AdyanshSahai/AquaLux/static/AquaLux.kicad_pcb

## KiCad design KiCAD_project/zdc_fifo_test/zdc_fifo_test.kicad_pcb

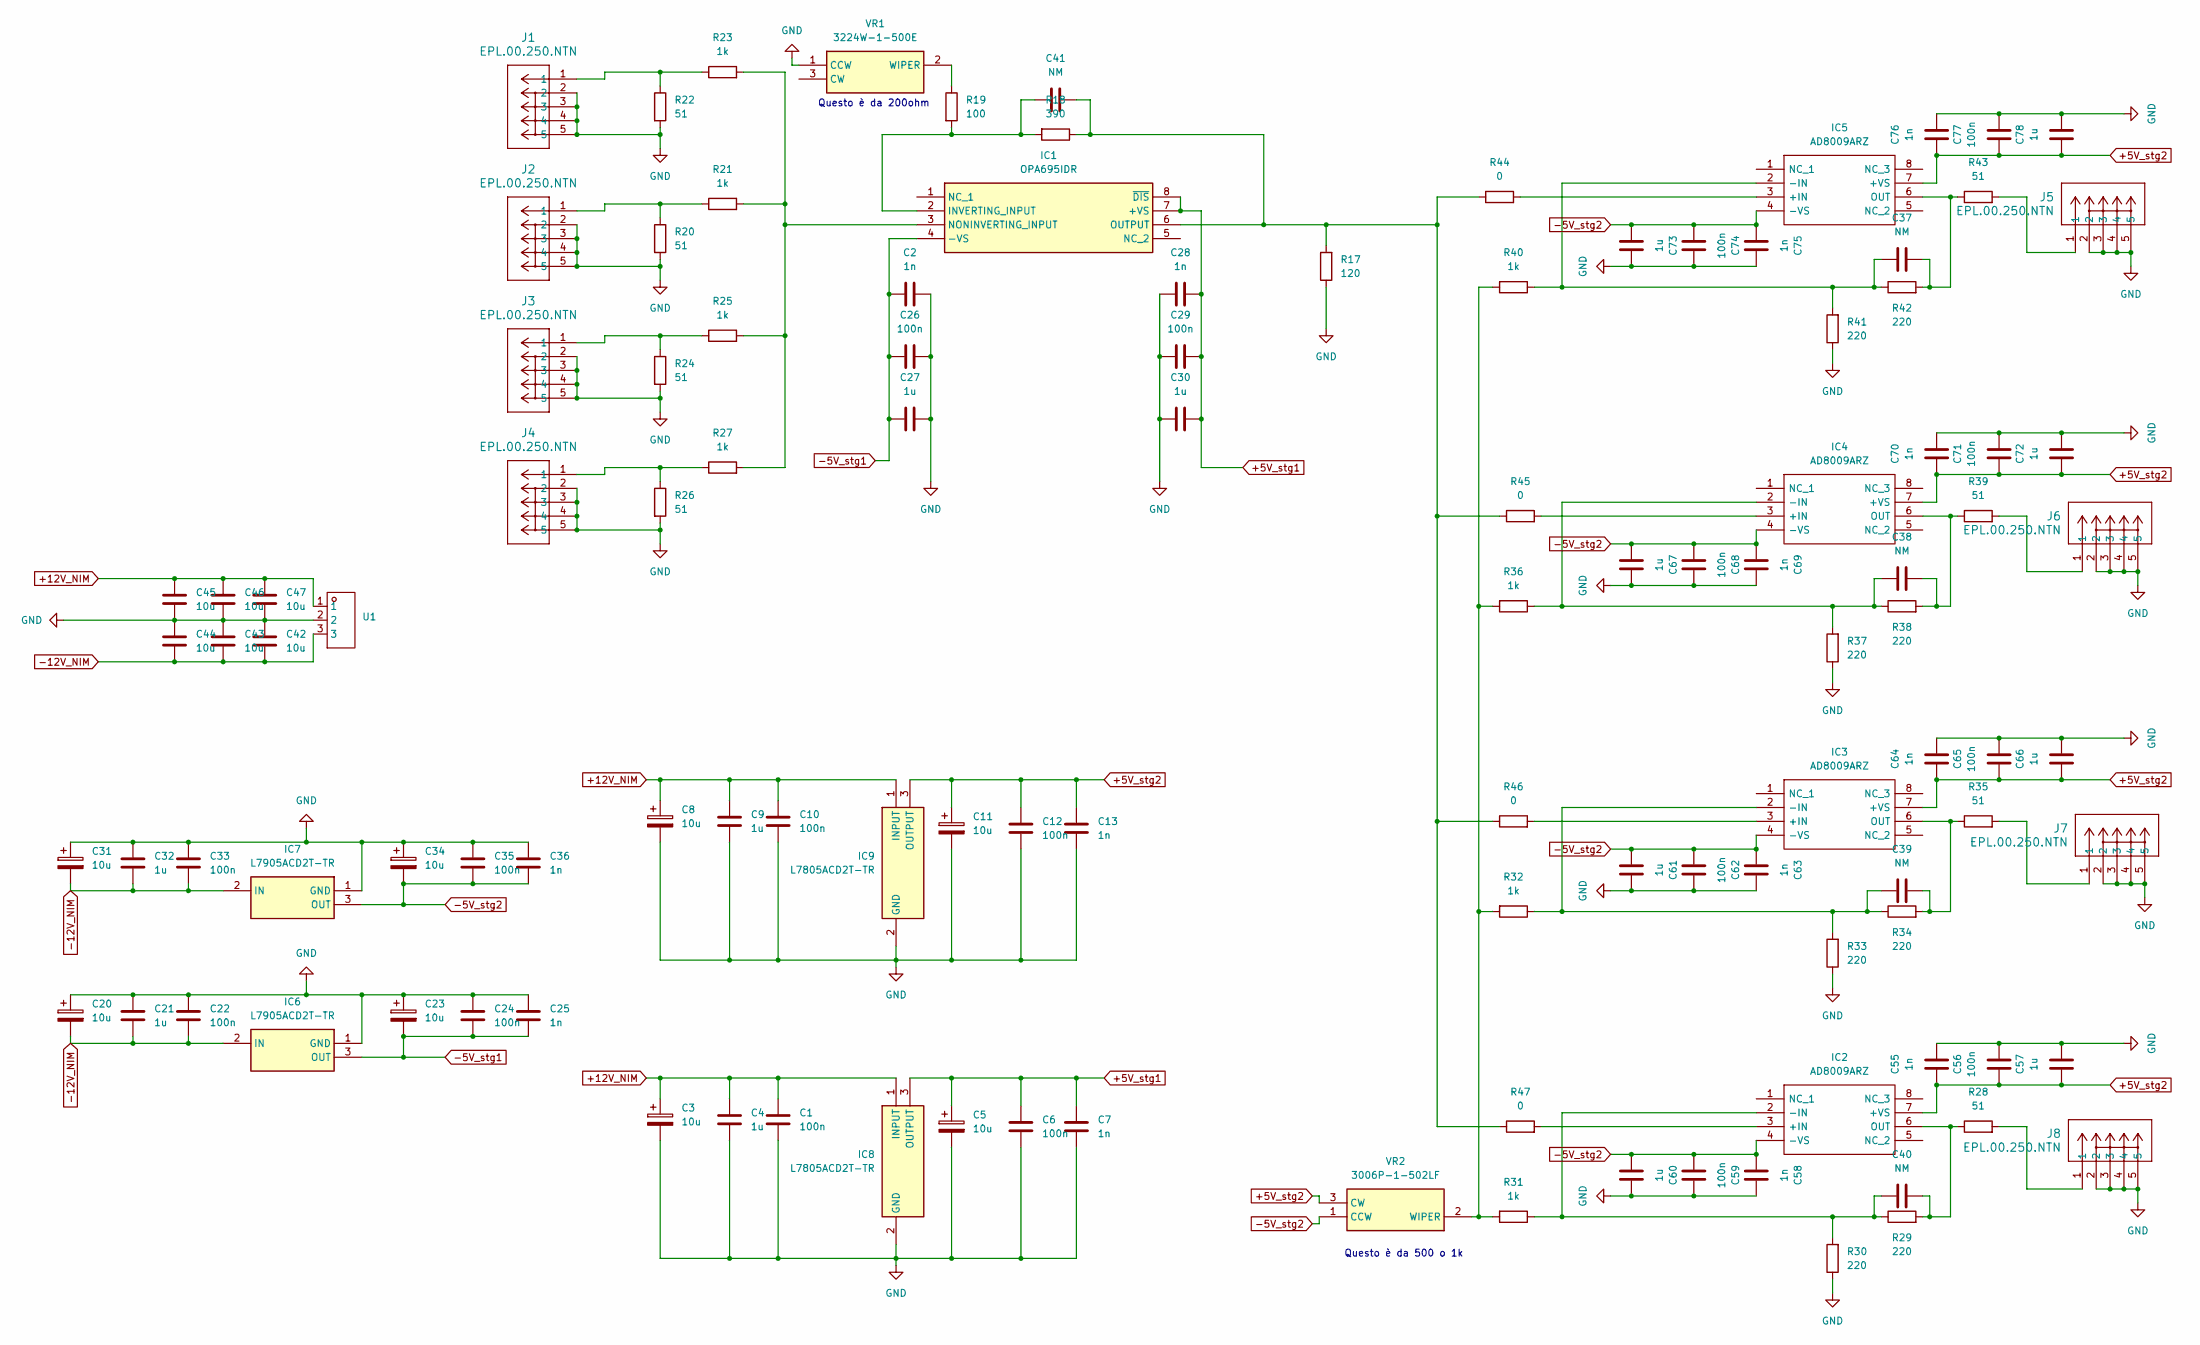
[picture p1: schematic zdc_fifo_test.kicad_sch, $ input 4 output]

Parts:
C1, C6, C10, C12, C22, C24, C26, C29, C33, C35, C56, C59, C62, C65, C68, C71, C74, C77: 100n; C_0402_1005Metric
C2, C7, C13, C25, C28, C36, C55, C58, C63, C64, C69, C70, C75, C76: 1n; C_0402_1005Metric
C3, C5, C8, C11, C31, C34, C42, C43, C44, C45, C46, C47: 10u; C_0805_2012Metric
C4, C9, C21, C30, C32, C57, C60, C61, C66, C67, C72, C73, C78: 1u; C_0603_1608Metric
C20: 10u; C_0805_2012Metric; JLCPCB C2836437
C23: 10u; C_0805_2012Metric; JLCPCB C15850
C27: 1u; C_0603_1608Metric; JLCPCB C15849
C37, C38, C39, C40, C41: NM; C_0402_1005Metric_Pad0.74x0.62mm_HandSolder
IC1: OPA695IDR; SOIC127P600X175-8N; Mouser Part Number 595-OPA695IDR
IC2, IC3, IC4, IC5: AD8009ARZ; SOIC127P600X175-8N; Mouser Part Number 584-AD8009ARZ
IC6, IC7: L7905ACD2T-TR; STB20N95K5; Mouser Part Number 511-L7905ACD2T-TR
IC8, IC9: L7805ACD2T-TR; L7805ACD2TTR; Mouser Part Number 511-L7805ACD2T-TR
J1, J2, J3, J4, J5, J6, J7, J8: EPL.00.250.NTN; CONN_EPK.00.250.NTN_LMO
R17: 120; R_0402_1005Metric
R18: 390; R_0603_1608Metric
R19: 100; R_0402_1005Metric
R20, R22, R24, R26, R28, R35, R39, R43: 51; R_0603_1608Metric
R21, R23, R25, R27, R31, R32, R36, R40: 1k; R_0402_1005Metric
R29, R30, R33, R34, R37, R38, R41, R42: 220; R_0402_1005Metric
R44, R45, R46, R47: 0; R_0603_1608Metric_Pad0.98x0.95mm_HandSolder
U1: CONN-TH_XY126V-5.0-3P; Manufacturer Part XY126V-5.0-3P; LCSC Part Name 1x3P 5mm 直插 排数:1 每排P数:3
VR1: 3224W-1-500E; 3224W1500E; Mouser Part Number 652-3224W-1-500E
VR2: 3006P-1-502LF; 3006P_1; Mouser Part Number 652-3006P-1-502-LF

Connections:
+5V_stg1: C5.1, C6.1, C7.1, C28.1, C29.1, C30.1, IC1.7 (+VS), IC1.8 (~DIS), IC8.3 (OUTPUT)
+5V_stg2: C11.1, C12.1, C13.1, C55.1, C56.1, C57.1, C64.1, C65.1, C66.1, C70.1, C71.1, C72.1, C76.1, C77.1, C78.1, IC2.7 (+VS), IC3.7 (+VS), IC4.7 (+VS), IC5.7 (+VS), IC9.3 (OUTPUT), VR2.3 (CW)
+12V_NIM: C1.1, C3.1, C4.1, C8.1, C9.1, C10.1, C45.1, C46.1, C47.1, IC8.1 (INPUT), IC9.1 (INPUT), U1.1
-5V_stg1: C2.1, C23.2, C24.2, C25.2, C26.1, C27.1, IC1.4 (-VS), IC6.3 (OUT)
-5V_stg2: C34.2, C35.2, C36.2, C58.1, C59.1, C60.1, C61.1, C62.1, C63.1, C67.1, C68.1, C69.1, C73.1, C74.1, C75.1, IC2.4 (-VS), IC3.4 (-VS), IC4.4 (-VS), IC5.4 (-VS), IC7.3 (OUT), VR2.1 (CCW)
-12V_NIM: C20.2, C21.2, C22.2, C31.2, C32.2, C33.2, C42.2, C43.2, C44.2, IC6.2 (IN), IC7.2 (IN), U1.3
GND: C1.2, C2.2, C3.2, C4.2, C5.2, C6.2, C7.2, C8.2, C9.2, C10.2, C11.2, C12.2, C13.2, C20.1, C21.1, C22.1, C23.1, C24.1, C25.1, C26.2, C27.2, C28.2, C29.2, C30.2, C31.1, C32.1, C33.1, C34.1, C35.1, C36.1, C42.1, C43.1, C44.1, C45.2, C46.2, C47.2, C55.2, C56.2, C57.2, C58.2, C59.2, C60.2, C61.2, C62.2, C63.2, C64.2, C65.2, C66.2, C67.2, C68.2, C69.2, C70.2, C71.2, C72.2, C73.2, C74.2, C75.2, C76.2, C77.2, C78.2, IC6.1 (GND), IC7.1 (GND), IC8.2 (GND), IC9.2 (GND), J1.2, J1.3, J1.4, J1.5, J2.2, J2.3, J2.4, J2.5, J3.2, J3.3, J3.4, J3.5, J4.2, J4.3, J4.4, J4.5, J5.2, J5.3, J5.4, J5.5, J6.2, J6.3, J6.4, J6.5, J7.2, J7.3, J7.4, J7.5, J8.2, J8.3, J8.4, J8.5, R17.1, R20.2, R22.2, R24.2, R26.2, R30.1, R33.1, R37.1, R41.1, U1.2, VR1.1 (CCW)
unnamed: C41.2, IC1.2 (INVERTING_INPUT), R18.2, R19.2
unnamed: IC1.3 (NONINVERTING_INPUT), R21.2, R23.2, R25.2, R27.2
unnamed: C41.1, IC1.6 (OUTPUT), R17.2, R18.1, R44.1, R45.1, R46.1, R47.1
unnamed: IC2.3 (+IN), R47.2
unnamed: C40.2, IC2.2 (-IN), R29.1, R30.2, R31.1
unnamed: C40.1, IC2.6 (OUT), R28.1, R29.2
unnamed: IC3.3 (+IN), R46.2
unnamed: C39.2, IC3.2 (-IN), R32.1, R33.2, R34.1
unnamed: C39.1, IC3.6 (OUT), R34.2, R35.1
unnamed: IC4.3 (+IN), R45.2
unnamed: C38.2, IC4.2 (-IN), R36.1, R37.2, R38.1
unnamed: C38.1, IC4.6 (OUT), R38.2, R39.1
unnamed: IC5.3 (+IN), R44.2
unnamed: C37.2, IC5.2 (-IN), R40.1, R41.2, R42.1
unnamed: C37.1, IC5.6 (OUT), R42.2, R43.1
unnamed: J1.1, R22.1, R23.1
unnamed: J2.1, R20.1, R21.1
unnamed: J3.1, R24.1, R25.1
unnamed: J4.1, R26.1, R27.1
unnamed: J5.1, R43.2
unnamed: J6.1, R39.2
unnamed: J7.1, R35.2
unnamed: J8.1, R28.2
unnamed: R19.1, VR1.2 (WIPER)
unnamed: R31.2, R32.2, R36.2, R40.2, VR2.2 (WIPER)

Notes on the sheet:
Questo è da 200ohm
Questo è da 500 o 1k

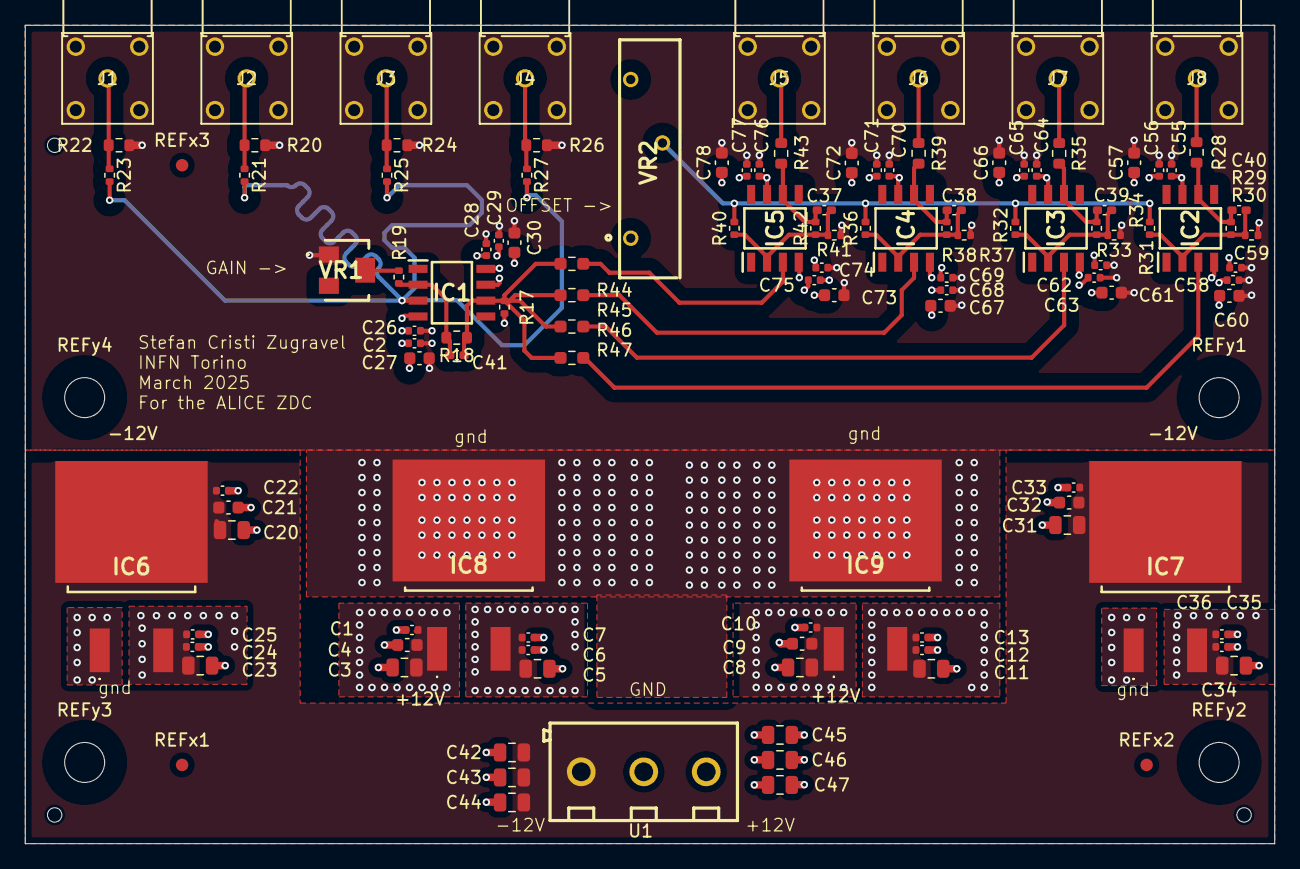
[picture p2: board zdc_fifo_test.kicad_pcb from above]

Board: 6 copper layers, 100.0 x 65.5 mm, 123 parts (0 on the bottom side), 32 nets.

Other parts of the board:
REFx1, REFx2, REFx3: Fiducial_1mm_Mask2mm
REFy1, REFy2, REFy3, REFy4: MountingHole_3.2mm_M3
