AdyanshSahai/AquaLux/src/main.cpp

/*
 * ============================================================
 *  AquaLux — Hydration Alarm System
 *  Platform : ESP32-S2 Mini (LOLIN / Wemos S2 Mini)
 *  Framework: Arduino (PlatformIO)
 * ============================================================
 *
 *  Boot flow
 *  ─────────
 *  1. Init pins + Serial
 *  2. Load Preferences (WiFi creds + alarm time)
 *  3. If creds found  → connect home WiFi → NTP sync → disconnect → AP mode
 *     If no creds     → AP mode immediately (first-time setup)
 *  4. Serve web UI at 192.168.4.1: set alarm, update WiFi, view sensor states
 *  5. At alarm time   → pulse buzzer via 2N2222 (500 ms on / 500 ms off)
 *  6. Alarm dismiss   → light ON + capacitive sensor triggered, both held >= 2 s
 *  7. 3 am daily      → brief home-WiFi reconnect for NTP resync
 *  8. Reset button    → hold 3 s → wipe Preferences → beep → reboot
 *
 *  File layout
 *  ───────────
 *  config.h        — all pin and timing constants (#defines)
 *  globals.h/.cpp  — shared state variables (extern declarations + definitions)
 *  wifi_ntp.h/.cpp — parseAlarmTime, loadPreferences, syncNTP
 *  sensors.h/.cpp  — readSensors
 *  alarm.h/.cpp    — triggerAlarm, updateBuzzerPulse, handleAlarmDismiss
 *  webserver.h/.cpp— embedded HTML + HTTP route handlers
 *  reset_button.h/.cpp — handleResetButton
 *  main.cpp        — setup() and loop() (this file)
 *
 *  NOTE — light sleep: cannot be used while the AsyncWebServer AP is active.
 *  Light sleep suspends the WiFi radio, which disconnects AP clients.
 *  Using delay() instead — it yields to FreeRTOS background tasks (WiFi stack,
 *  web server handler task, watchdog) without touching the radio.
 */

// ── Pull in all subsystems ────────────────────────────────────
// Each header transitively includes globals.h → all library headers + config.h,
// so this list is all that is needed here.
#include "wifi_ntp.h"
#include "sensors.h"
#include "alarm.h"
#include "webserver.h"
#include "reset_button.h"

// ============================================================
//  setup()
// ============================================================

void setup() {
    // ── Serial monitor ────────────────────────────────────────
    Serial.begin(115200);
    Serial.setTxTimeoutMs(0); // ESP32-S2 uses USB CDC — without this, Serial.print blocks/drops
                               // output if the USB host isn't ready yet; 0 = never block, just drop
    delay(2000);              // Give USB CDC time to enumerate before printing anything
    Serial.println("\n===== AquaLux BOOT =====");

    // ── Pin configuration ─────────────────────────────────────
    pinMode(BUZZER_PIN,      OUTPUT);
    digitalWrite(BUZZER_PIN, LOW);          // Explicitly off on boot

    pinMode(CAP_SENSOR_PIN,  INPUT);       // Capacitive sensor module has its own pull resistors
    pinMode(PHOTO_PIN,       INPUT);       // LDR module DO pin; module has its own pull resistors
    pinMode(RESET_PIN,       INPUT_PULLUP); // Internal pull-up; LOW = button pressed = counting down

    Serial.println("[SETUP] Pins configured");

    // ── Load stored configuration from NVS ────────────────────
    bool hasCreds = loadPreferences(); // Populates storedSSID, storedPassword, alarmHour, alarmMinute

    // ── NTP sync or first-time AP setup ───────────────────────
    // IMPORTANT: timeClient.begin() opens a lwIP UDP socket and must be called AFTER the WiFi
    // stack is initialised (i.e. after WiFi.mode()). Calling it before WiFi.mode() causes an
    // "Invalid mbox" assertion crash inside tcpip_send_msg_wait_sem.
    if (hasCreds) {
        // Credentials available — sync time before opening the AP so the clock is correct immediately
        Serial.println("[SETUP] Credentials found — running NTP sync");
        syncNTP(); // Calls WiFi.mode(AP_STA), connects, timeClient.begin()+forceUpdate, disconnects, softAP
    } else {
        // No credentials — bring up AP first, then open the UDP socket for NTP
        Serial.println("[SETUP] No credentials — entering AP setup mode");
        WiFi.mode(WIFI_AP);
        WiFi.setTxPower(WIFI_POWER_8_5dBm); // Reduce TX power to cut peak current draw
        WiFi.softAP(AP_SSID);           // Open AP, no password
        timeClient.begin();              // Safe here — WiFi stack is now initialised
        Serial.printf("[SETUP] AP up: SSID='%s'  IP=%s\n", AP_SSID, AP_GATEWAY_IP);
    }

    // ── Start web server ──────────────────────────────────────
    // AP must be running before this; server.begin() registers with the WiFi event loop
    setupWebServer();

    // ── Initial sensor snapshot ───────────────────────────────
    // Populate the global sensor booleans so the /status endpoint has real values immediately
    readSensors();

    Serial.printf("[SETUP] Boot complete | Alarm=%02d:%02d | Time known=%s\n",
                  alarmHour, alarmMinute,
                  isAnyTimeSet() ? "YES" : "NO (set manually in Config or sync WiFi)");
    Serial.println("===== AquaLux RUNNING =====\n");
}

// ============================================================
//  loop()
// ============================================================

void loop() {
    // ── 1. Reset button ───────────────────────────────────────
    // Checked every iteration — highest priority so a reset can interrupt even an active alarm
    handleResetButton();

    // ── 2. Time-dependent logic (only valid once NTP has synced) ──
    if (isAnyTimeSet()) {
        int curHour   = getCurrentHour();
        int curMinute = getCurrentMinute();

        // ── 2a. Daily 3 am NTP resync ─────────────────────────
        // Fires once per day at exactly NTP_RESYNC_HOUR:NTP_RESYNC_MINUTE
        if (curHour == NTP_RESYNC_HOUR && curMinute == NTP_RESYNC_MINUTE && !ntpResynced3am) {
            Serial.println("[LOOP] 3 am NTP resync triggered");
            syncNTP();             // Reconnect home WiFi, resync, disconnect, restore AP
            ntpResynced3am = true; // Block re-trigger for the rest of this minute
        } else if (!(curHour == NTP_RESYNC_HOUR && curMinute == NTP_RESYNC_MINUTE)) {
            // Reset flag once we leave the 3 am minute so it fires again tomorrow
            ntpResynced3am = false;
        }

        // ── 2b. Alarm trigger ─────────────────────────────────
        if (curHour == alarmHour && curMinute == alarmMinute) {
            if (!alarmActive && !alarmFiredThisMinute) {
                // Fire once per clock-minute; alarmFiredThisMinute prevents re-trigger if the
                // alarm is dismissed and the minute hasn't changed yet (e.g. dismissed at 07:00:30)
                Serial.printf("[LOOP] Alarm time %02d:%02d reached — triggering\n", curHour, curMinute);
                triggerAlarm();
                alarmFiredThisMinute = true;
            }
        } else {
            // Outside the alarm minute — clear the one-shot guard so it fires again tomorrow
            alarmFiredThisMinute = false;
        }
    }

    // ── 3. Sensor read (every iteration) + active alarm handling ──
    readSensors(); // Always refresh sensor globals so the web UI stays live even without an active alarm

    if (alarmActive) {
        updateBuzzerPulse();  // Toggle buzzer ON/OFF per BUZZER_ON_MS / BUZZER_OFF_MS (non-blocking)
        handleAlarmDismiss(); // Run 2 s debounce; silences alarm if all conditions held long enough
    }

    // ── 4. Yield delay ────────────────────────────────────────
    // Light sleep is NOT used: it suspends the WiFi radio, which disconnects AP clients and
    // pauses the AsyncWebServer. delay() yields the CPU to all FreeRTOS background tasks
    // (WiFi stack, web server handler task, watchdog timer) without disturbing the radio.
    delay(alarmActive ? LOOP_ALARM_DELAY_MS : LOOP_IDLE_DELAY_MS);
}
