AdyanshSahai/AquaLux/src/webserver.cpp

// ============================================================
//  webserver.cpp — Embedded HTML UI and HTTP route handlers
//
//  Routes:
//    GET  /         — serve the three-mode UI from PROGMEM
//    GET  /status   — JSON snapshot of time + sensor/buzzer/alarm states
//    POST /setalarm — update alarm time in NVS + globals (no reboot)
//    POST /buzzer   — manually drive BUZZER_PIN (dev mode)
//    POST /save     — write WiFi credentials + current alarm to NVS → reboot
// ============================================================

#include "webserver.h"
#include "wifi_ntp.h"   // parseAlarmTime()

static bool     buzzerTestState = false;
static int      scanState       = 0;   // 0=idle, 1=scanning, 2=done
static String   scanJson        = "[]";
static uint32_t calNothing      = 0;   // raw cap reading with nothing on pad
static uint32_t calBottle       = 0;   // raw cap reading with bottle on pad
static uint32_t calHand         = 0;   // raw cap reading with hand on pad

static const char INDEX_HTML[] PROGMEM = R"rawliteral(
<!DOCTYPE html>
<html lang="en">
<head>
  <meta charset="UTF-8">
  <meta name="viewport" content="width=device-width,initial-scale=1">
  <title>AquaLux</title>
  <style>
    *, *::before, *::after { box-sizing: border-box; margin: 0; padding: 0; }

    body {
      background: #0d0d0d;
      color: #e0e0e0;
      font-family: -apple-system, BlinkMacSystemFont, 'Segoe UI', sans-serif;
      min-height: 100vh;
    }

    /* ── Top bar ─────────────────────────────────────────────── */
    .topbar {
      position: relative;
      display: flex;
      align-items: center;
      height: 52px;
      padding: 0 16px;
      background: #141414;
      border-bottom: 1px solid #1f1f1f;
      z-index: 100;
    }

    .topbar-title {
      position: absolute;
      left: 50%;
      transform: translateX(-50%);
      font-size: 1rem;
      font-weight: 700;
      color: #fff;
      letter-spacing: 0.08em;
    }

    /* ── Hamburger button ────────────────────────────────────── */
    .ham-btn {
      background: none;
      border: none;
      cursor: pointer;
      padding: 6px;
      display: flex;
      flex-direction: column;
      gap: 5px;
    }

    .ham-btn span {
      display: block;
      width: 22px;
      height: 2px;
      background: #ccc;
      border-radius: 2px;
      transition: background 0.2s;
    }

    .ham-btn:hover span { background: #fff; }

    /* ── Dropdown menu ───────────────────────────────────────── */
    .dropdown {
      position: absolute;
      top: 52px;
      left: 0;
      width: 180px;
      background: #1a1a1a;
      border: 1px solid #2a2a2a;
      border-radius: 0 0 10px 10px;
      z-index: 200;
      overflow: hidden;
    }

    .dropdown.hidden { display: none; }

    .dropdown a {
      display: block;
      padding: 13px 18px;
      font-size: 0.9rem;
      color: #ccc;
      cursor: pointer;
      border-bottom: 1px solid #222;
      transition: background 0.15s, color 0.15s;
      user-select: none;
    }

    .dropdown a:last-child { border-bottom: none; }
    .dropdown a:hover { background: #222; color: #fff; }
    .dropdown a.active { color: #4ade80; }

    /* ── Main content ────────────────────────────────────────── */
    .content {
      padding: 28px 16px 48px;
      max-width: 420px;
      margin: 0 auto;
    }

    .mode-panel { display: none; }
    .mode-panel.active { display: block; }

    /* ── Section headings ────────────────────────────────────── */
    .panel-title {
      font-size: 1.1rem;
      font-weight: 700;
      color: #fff;
      margin-bottom: 6px;
    }

    .panel-sub {
      font-size: 0.75rem;
      color: #555;
      margin-bottom: 24px;
    }

    /* ── Cards ───────────────────────────────────────────────── */
    .card {
      background: #141414;
      border: 1px solid #1f1f1f;
      border-radius: 14px;
      overflow: hidden;
      margin-bottom: 14px;
    }

    .row {
      display: flex;
      align-items: center;
      justify-content: space-between;
      padding: 14px 16px;
      border-bottom: 1px solid #1a1a1a;
    }

    .row:last-child { border-bottom: none; }

    .label { font-size: 0.9rem; color: #ccc; }

    /* ── Form inputs ─────────────────────────────────────────── */
    .field { margin-bottom: 16px; }

    .field label {
      display: block;
      font-size: 0.78rem;
      color: #888;
      margin-bottom: 6px;
      letter-spacing: 0.04em;
      text-transform: uppercase;
    }

    .field input {
      width: 100%;
      background: #141414;
      border: 1px solid #2a2a2a;
      border-radius: 10px;
      color: #fff;
      font-size: 1rem;
      padding: 11px 14px;
      outline: none;
      transition: border-color 0.2s;
      -webkit-appearance: none;
    }

    .field input:focus { border-color: #4ade80; }
    .field input:disabled {
      opacity: 0.4;
      cursor: not-allowed;
    }

    /* ── Buttons ─────────────────────────────────────────────── */
    .btn {
      width: 100%;
      padding: 13px;
      border: none;
      border-radius: 10px;
      font-size: 0.95rem;
      font-weight: 600;
      cursor: pointer;
      transition: opacity 0.2s;
    }

    .btn:disabled { opacity: 0.4; cursor: not-allowed; }
    .btn-green { background: #166534; color: #4ade80; }
    .btn-green:hover:not(:disabled) { opacity: 0.85; }
    .btn-blue  { background: #1e3a5f; color: #60a5fa; }
    .btn-blue:hover:not(:disabled)  { opacity: 0.85; }

    /* ── Status light (alarm mode) ───────────────────────────── */
    .status-wrap {
      display: flex;
      flex-direction: column;
      align-items: center;
      margin-top: 28px;
      gap: 10px;
    }

    .status-dot {
      width: 40px;
      height: 40px;
      border-radius: 50%;
      background: #166534;
      box-shadow: 0 0 12px #4ade8044;
      transition: background 0.3s, box-shadow 0.3s;
    }

    .status-dot.alarming {
      background: #991b1b;
      box-shadow: 0 0 18px #ef444466;
      animation: pulse-red 1s ease-in-out infinite;
    }

    @keyframes pulse-red {
      0%, 100% { box-shadow: 0 0 12px #ef444444; }
      50%       { box-shadow: 0 0 28px #ef4444aa; }
    }

    .status-label {
      font-size: 0.8rem;
      color: #666;
    }

    /* ── Sensor badges ───────────────────────────────────────── */
    .badge {
      font-size: 0.7rem;
      font-weight: 600;
      letter-spacing: 0.06em;
      text-transform: uppercase;
      padding: 3px 8px;
      border-radius: 20px;
      background: #1f1f1f;
      color: #555;
      min-width: 40px;
      text-align: center;
      transition: background 0.2s, color 0.2s;
    }

    .badge.on  { background: #14532d; color: #4ade80; }
    .badge.off { background: #1f1f1f; color: #555; }

    /* ── Time display (dev mode) ─────────────────────────────── */
    .time-display {
      font-size: 2rem;
      font-weight: 700;
      color: #fff;
      font-variant-numeric: tabular-nums;
      letter-spacing: 0.04em;
      margin-bottom: 20px;
    }

    /* ── Toggle switch ───────────────────────────────────────── */
    .toggle {
      position: relative;
      width: 44px;
      height: 24px;
      flex-shrink: 0;
    }

    .toggle input {
      opacity: 0;
      width: 0;
      height: 0;
      position: absolute;
    }

    .slider {
      position: absolute;
      inset: 0;
      background: #333;
      border-radius: 24px;
      cursor: pointer;
      transition: background 0.2s;
    }

    .slider::before {
      content: '';
      position: absolute;
      width: 18px;
      height: 18px;
      left: 3px;
      top: 3px;
      background: #888;
      border-radius: 50%;
      transition: transform 0.2s, background 0.2s;
    }

    .toggle input:checked + .slider { background: #166534; }
    .toggle input:checked + .slider::before {
      transform: translateX(20px);
      background: #4ade80;
    }

    /* ── Setup message ───────────────────────────────────────── */
    .msg {
      font-size: 0.8rem;
      margin-top: 12px;
      padding: 10px 14px;
      border-radius: 8px;
      display: none;
    }

    .msg.ok  { background: #14532d44; color: #4ade80; display: block; }
    .msg.err { background: #7f1d1d44; color: #f87171; display: block; }

    /* ── WiFi scan results ───────────────────────────────────── */
    .scan-list {
      margin-top: 8px;
      border: 1px solid #2a2a2a;
      border-radius: 10px;
      overflow: hidden;
      display: none;
    }

    .scan-list.visible { display: block; }

    .scan-item {
      display: flex;
      align-items: center;
      justify-content: space-between;
      padding: 11px 14px;
      border-bottom: 1px solid #1a1a1a;
      cursor: pointer;
      transition: background 0.15s;
    }

    .scan-item:last-child { border-bottom: none; }
    .scan-item:hover { background: #1e1e1e; }

    .scan-item .ssid-name { font-size: 0.9rem; color: #ddd; }
    .scan-item .rssi {
      font-size: 0.75rem;
      color: #555;
    }

    /* ── Saved network select ────────────────────────────────── */
    .net-select {
      width: 100%;
      background: #141414;
      border: 1px solid #2a2a2a;
      border-radius: 10px;
      color: #fff;
      font-size: 1rem;
      padding: 11px 14px;
      outline: none;
      -webkit-appearance: none;
      appearance: none;
      cursor: pointer;
    }
    .net-select:focus { border-color: #4ade80; }
    .net-select option { background: #1a1a1a; }

    /* ── Calibration value display ───────────────────────────── */
    .cal-row {
      display: flex;
      justify-content: space-between;
      font-size: 0.78rem;
      color: #666;
    }
    .cal-row span { color: #aaa; font-variant-numeric: tabular-nums; }
  </style>
</head>
<body>

  <!-- ── Top bar ──────────────────────────────────────────── -->
  <header class="topbar">
    <button class="ham-btn" id="ham-btn" aria-label="Menu">
      <span></span><span></span><span></span>
    </button>
    <span class="topbar-title">AquaLux</span>
  </header>

  <!-- ── Dropdown nav ─────────────────────────────────────── -->
  <nav class="dropdown hidden" id="dropdown">
    <a id="nav-alarm"  class="active" onclick="setMode('alarm')">Alarm</a>
    <a id="nav-setup"                 onclick="setMode('setup')">Setup</a>
    <a id="nav-dev"                   onclick="setMode('dev')">Dev</a>
    <a id="nav-config"                onclick="setMode('config')">Config</a>
  </nav>

  <!-- ── Content ──────────────────────────────────────────── -->
  <div class="content">

    <!-- ── ALARM MODE ──────────────────────────────────────── -->
    <section class="mode-panel active" id="panel-alarm">
      <p class="panel-title">Alarm</p>
      <p class="panel-sub">Set your daily hydration reminder</p>

      <div class="card">
        <div class="row" style="flex-direction:column;align-items:flex-start;gap:10px;">
          <div class="field" style="width:100%;margin-bottom:0;">
            <label>Alarm Time</label>
            <input type="time" id="alarm-input" value="07:00">
          </div>
          <button class="btn btn-green" id="save-btn" onclick="saveAlarm()">Save</button>
        </div>
      </div>

      <div class="status-wrap">
        <div class="status-dot" id="status-dot"></div>
        <span class="status-label" id="status-label">Not ringing</span>
      </div>
    </section>

    <!-- ── SETUP MODE ──────────────────────────────────────── -->
    <section class="mode-panel" id="panel-setup">
      <p class="panel-title">WiFi Setup</p>
      <p class="panel-sub">Connect to home WiFi for automatic time sync</p>

      <div class="card">
        <div class="row" style="flex-direction:column;align-items:flex-start;gap:4px;">
          <div class="field" style="width:100%;">
            <label>Saved Networks</label>
            <select class="net-select" id="net-select" onchange="onNetSelect()">
              <option value="">-- New network --</option>
            </select>
          </div>
          <div class="field" style="width:100%;">
            <label>Network Name (SSID)</label>
            <input type="text" id="ssid-input" placeholder="Your WiFi name" autocomplete="off">
          </div>
          <div class="field" style="width:100%;margin-bottom:0;">
            <label>Password</label>
            <input type="text" id="pass-input" placeholder="WiFi password" autocomplete="off">
          </div>
        </div>
        <div class="row">
          <button class="btn btn-blue" id="connect-btn" onclick="saveWifi()">Connect &amp; Sync</button>
        </div>
      </div>

      <p class="msg" id="setup-msg"></p>

      <div class="card" style="margin-top:14px;">
        <div class="row">
          <span class="label">Current time</span>
          <span style="font-size:1rem;font-weight:700;color:#fff;font-variant-numeric:tabular-nums;" id="setup-time">--:--:--</span>
        </div>
        <div class="row">
          <button class="btn btn-blue" id="sync-btn" onclick="syncTime()">Sync Time Now</button>
        </div>
      </div>
    </section>

    <!-- ── DEV MODE ────────────────────────────────────────── -->
    <section class="mode-panel" id="panel-dev">
      <p class="panel-title">Dev</p>
      <p class="panel-sub">Live sensor readings and buzzer control</p>

      <div class="time-display" id="cur-time">--:--:--</div>

      <div class="card">
        <div class="row">
          <span class="label">Capacitive sensor</span>
          <span style="display:flex;align-items:center;gap:8px;">
            <span style="font-size:0.85rem;color:#aaa;font-variant-numeric:tabular-nums;" id="cap-raw">--</span>
            <span class="badge off" id="b-cap">OFF</span>
          </span>
        </div>
        <div class="row">
          <span class="label">Photoresistor</span>
          <span class="badge off" id="b-light">OFF</span>
        </div>
        <div class="row">
          <span class="label">Alarm active</span>
          <span class="badge off" id="b-alarm">OFF</span>
        </div>
      </div>

      <div class="card">
        <div class="row">
          <span class="label">Buzzer</span>
          <label class="toggle">
            <input type="checkbox" id="toggle-buzzer" onchange="setBuzzer(this.checked)">
            <span class="slider"></span>
          </label>
        </div>
      </div>

    </section>

    <!-- ── CONFIG MODE ───────────────────────────────────────── -->
    <section class="mode-panel" id="panel-config">
      <p class="panel-title">Config</p>
      <p class="panel-sub">Device status and threshold settings</p>

      <div class="card">
        <div class="row">
          <span class="label">Stored SSID</span>
          <span style="font-size:0.85rem;color:#aaa;max-width:55%;overflow:hidden;text-overflow:ellipsis;white-space:nowrap;" id="cfg-ssid">--</span>
        </div>
        <div class="row">
          <span class="label">NTP synced</span>
          <span class="badge off" id="cfg-ntp">NO</span>
        </div>
        <div class="row">
          <span class="label">Current time</span>
          <span style="font-size:0.85rem;color:#fff;font-variant-numeric:tabular-nums;" id="cfg-time">--:--:--</span>
        </div>
      </div>

      <div class="card" style="margin-top:14px;">
        <div class="row" style="flex-direction:column;align-items:flex-start;gap:12px;">
          <span class="label" style="font-weight:600;color:#fff;">Set Time Manually</span>
          <input type="time" id="manual-time" step="1" style="width:100%;background:#141414;border:1px solid #2a2a2a;border-radius:10px;color:#fff;font-size:1rem;padding:11px 14px;outline:none;">
          <button class="btn btn-green" id="manual-time-btn" onclick="setManualTime()">Set Time</button>
        </div>
      </div>

      <div class="card" style="margin-top:14px;">
        <div class="row" style="flex-direction:column;align-items:flex-start;gap:12px;">
          <span class="label" style="font-weight:600;color:#fff;">Cap Thresholds</span>
          <div class="field" style="width:100%;margin-bottom:0;">
            <label>Min (bottle lower bound)</label>
            <input type="number" id="thresh-min" placeholder="e.g. 17000">
          </div>
          <div class="field" style="width:100%;margin-bottom:0;">
            <label>Max (bottle upper bound)</label>
            <input type="number" id="thresh-max" placeholder="e.g. 21000">
          </div>
          <button class="btn btn-green" id="thresh-save-btn" onclick="saveThresholds()">Save Thresholds</button>
        </div>
      </div>

      <div class="card" style="margin-top:14px;">
        <div class="row" style="flex-direction:column;align-items:flex-start;gap:12px;">
          <span class="label" style="font-weight:600;color:#fff;">Auto-Calibrate</span>
          <p style="font-size:0.75rem;color:#555;margin-top:-4px;">Place each item on the pad, then tap its button.</p>
          <div style="display:flex;gap:8px;width:100%;">
            <button class="btn btn-blue"  id="cal-nothing-btn" onclick="calibrate('nothing')" style="flex:1;font-size:0.8rem;padding:10px 4px;">Nothing</button>
            <button class="btn btn-green" id="cal-bottle-btn"  onclick="calibrate('bottle')"  style="flex:1;font-size:0.8rem;padding:10px 4px;">Bottle</button>
            <button class="btn btn-blue"  id="cal-hand-btn"    onclick="calibrate('hand')"    style="flex:1;font-size:0.8rem;padding:10px 4px;">Hand</button>
          </div>
          <div id="cal-status" style="width:100%;"></div>
        </div>
      </div>
    </section>

  </div><!-- .content -->

  <script>
    // ── Mode switching ────────────────────────────────────────
    function setMode(mode) {
      document.querySelectorAll('.mode-panel').forEach(p => p.classList.remove('active'));
      document.querySelectorAll('.dropdown a').forEach(a => a.classList.remove('active'));
      document.getElementById('panel-' + mode).classList.add('active');
      document.getElementById('nav-' + mode).classList.add('active');
      document.getElementById('dropdown').classList.add('hidden');
    }

    document.getElementById('ham-btn').addEventListener('click', function(e) {
      e.stopPropagation();
      document.getElementById('dropdown').classList.toggle('hidden');
    });

    document.addEventListener('click', function(e) {
      const dd = document.getElementById('dropdown');
      if (!dd.classList.contains('hidden') &&
          !dd.contains(e.target) &&
          e.target !== document.getElementById('ham-btn')) {
        dd.classList.add('hidden');
      }
    });

    // ── Alarm save ────────────────────────────────────────────
    async function saveAlarm() {
      const val = document.getElementById('alarm-input').value;
      if (!val) return;
      const btn = document.getElementById('save-btn');
      btn.disabled = true;
      try {
        const r = await fetch('/setalarm', {
          method: 'POST',
          body: new URLSearchParams({ alarm: val })
        });
        btn.textContent = r.ok ? 'Saved!' : 'Error';
        setTimeout(() => { btn.textContent = 'Save'; btn.disabled = false; }, 2000);
      } catch(_) {
        btn.textContent = 'Error';
        setTimeout(() => { btn.textContent = 'Save'; btn.disabled = false; }, 2000);
      }
    }

    // ── WiFi save (reboots device) ────────────────────────────
    async function saveWifi() {
      const ssid = document.getElementById('ssid-input').value.trim();
      const pass = document.getElementById('pass-input').value;
      const msg  = document.getElementById('setup-msg');
      const btn  = document.getElementById('connect-btn');

      if (!ssid) {
        msg.className = 'msg err';
        msg.textContent = 'Please enter a network name.';
        return;
      }

      btn.textContent = 'Connecting...';
      btn.disabled = true;
      msg.className = 'msg';

      try {
        await fetch('/save', {
          method: 'POST',
          body: new URLSearchParams({ ssid: ssid, pass: pass })
        });
        msg.className = 'msg ok';
        msg.textContent = 'Credentials saved — device is rebooting. Reconnect to AquaLux to continue.';
      } catch(_) {
        msg.className = 'msg ok';
        msg.textContent = 'Device is rebooting. Reconnect to AquaLux to continue.';
      }
    }

    // ── NTP sync ──────────────────────────────────────────────
    async function syncTime() {
      const btn = document.getElementById('sync-btn');
      btn.textContent = 'Syncing...';
      btn.disabled = true;
      try {
        const r = await fetch('/synctime', { method: 'POST' });
        const ok = (await r.text()) === 'OK';
        btn.textContent = ok ? 'Synced!' : 'Failed';
      } catch(_) {
        btn.textContent = 'Failed';
      }
      setTimeout(() => { btn.textContent = 'Sync Time Now'; btn.disabled = false; }, 2500);
    }

    // ── Saved networks dropdown ───────────────────────────────
    let savedNetworks = [];

    async function loadNetworks() {
      try {
        const r = await fetch('/networks');
        savedNetworks = await r.json();
        const sel = document.getElementById('net-select');
        sel.innerHTML = '<option value="">-- New network --</option>';
        savedNetworks.forEach((n, i) => {
          const opt = document.createElement('option');
          opt.value = i;
          opt.textContent = n.ssid;
          sel.appendChild(opt);
        });
      } catch(_) {}
    }

    function onNetSelect() {
      const sel = document.getElementById('net-select');
      const ssidInput = document.getElementById('ssid-input');
      const passInput = document.getElementById('pass-input');
      if (sel.value === '') {
        ssidInput.value = '';
        passInput.value = '';
        ssidInput.disabled = false;
      } else {
        const net = savedNetworks[parseInt(sel.value)];
        ssidInput.value = net.ssid;
        passInput.value = net.pass;
        ssidInput.disabled = true;
      }
    }

    // ── Cap sensor calibration ────────────────────────────────
    async function calibrate(type) {
      const btn = document.getElementById('cal-' + type + '-btn');
      btn.disabled = true;
      try {
        const r = await fetch('/calibrate', {
          method: 'POST',
          body: new URLSearchParams({ type: type })
        });
        const d = await r.json();
        renderCalStatus(d);
        btn.textContent = { nothing: 'Nothing ✓', bottle: 'Bottle ✓', hand: 'Hand ✓' }[type];
      } catch(_) {
        btn.textContent = 'Error';
      }
      setTimeout(() => {
        btn.disabled = false;
        btn.textContent = { nothing: 'Nothing', bottle: 'Bottle', hand: 'Hand' }[type];
      }, 2000);
    }

    function renderCalStatus(d) {
      const el = document.getElementById('cal-status');
      if (!el) return;
      let html = '<div style="line-height:1.9;font-size:0.78rem;">';
      html += `<div class="cal-row">Nothing: <span>${d.nothing || '--'}</span></div>`;
      html += `<div class="cal-row">Bottle:  <span>${d.bottle  || '--'}</span></div>`;
      html += `<div class="cal-row">Hand:    <span>${d.hand    || '--'}</span></div>`;
      if (d.nothing && d.bottle && d.hand) {
        html += `<div class="cal-row" style="margin-top:6px;color:#4ade80;">Min threshold: <span style="color:#4ade80;">${d.min}</span></div>`;
        html += `<div class="cal-row" style="color:#4ade80;">Max threshold: <span style="color:#4ade80;">${d.max}</span></div>`;
      }
      html += '</div>';
      el.innerHTML = html;
    }

    // ── Buzzer toggle (dev mode) ──────────────────────────────
    async function setBuzzer(on) {
      try {
        await fetch('/buzzer', {
          method: 'POST',
          body: new URLSearchParams({ on: on ? '1' : '0' })
        });
      } catch(_) {}
    }

    // ── Status polling ────────────────────────────────────────
    function badge(id, on) {
      const el = document.getElementById(id);
      if (!el) return;
      el.textContent = on ? 'ON' : 'OFF';
      el.className   = 'badge ' + (on ? 'on' : 'off');
    }

    async function poll() {
      try {
        const r    = await fetch('/status');
        const d    = await r.json();
        const ring = !!d.alarmActive;

        // ── Alarm panel ───────────────────────────────────────
        const dot = document.getElementById('status-dot');
        dot.className = 'status-dot' + (ring ? ' alarming' : '');
        document.getElementById('status-label').textContent =
          ring ? 'Alarm is ringing!' : 'Not ringing';

        const inp = document.getElementById('alarm-input');
        const btn = document.getElementById('save-btn');
        inp.disabled = ring;
        btn.disabled = ring;

        // Only push server value when user is not actively editing the field
        if (d.alarmTime && document.activeElement !== inp) {
          inp.value = d.alarmTime;
        }

        // ── Setup panel time display ──────────────────────────
        document.getElementById('setup-time').textContent = d.time || '--:--:--';

        // ── Dev panel ─────────────────────────────────────────
        document.getElementById('cur-time').textContent = d.time || '--:--:--';
        const capRawEl = document.getElementById('cap-raw');
        if (capRawEl) capRawEl.textContent = d.capRaw ?? '--';
        badge('b-cap',   d.capDetected);
        badge('b-light', !d.lightDetected); // module LOW = light on, so invert for display
        badge('b-alarm', d.alarmActive);
        document.getElementById('toggle-buzzer').checked = !!d.buzzerOn;

        // ── Config panel ──────────────────────────────────────
        const cfgSsid = document.getElementById('cfg-ssid');
        if (cfgSsid) cfgSsid.textContent = d.storedSSID || '(none)';
        const cfgNtp = document.getElementById('cfg-ntp');
        if (cfgNtp) {
          cfgNtp.textContent = d.timeSet ? 'YES' : 'NO';
          cfgNtp.className = 'badge ' + (d.timeSet ? 'on' : 'off');
        }
        const cfgTime = document.getElementById('cfg-time');
        if (cfgTime) cfgTime.textContent = d.time || '--:--:--';
        // Populate threshold inputs only when not focused
        const tMin = document.getElementById('thresh-min');
        const tMax = document.getElementById('thresh-max');
        if (tMin && document.activeElement !== tMin && d.capMin) tMin.value = d.capMin;
        if (tMax && document.activeElement !== tMax && d.capMax) tMax.value = d.capMax;

      } catch(_) {}
    }

    // ── Manual time set ───────────────────────────────────────
    async function setManualTime() {
      const val = document.getElementById('manual-time').value; // "HH:MM" or "HH:MM:SS"
      if (!val) return;
      const parts = val.split(':').map(Number);
      const h = parts[0] || 0, m = parts[1] || 0, s = parts[2] || 0;
      const btn = document.getElementById('manual-time-btn');
      btn.disabled = true;
      try {
        const r = await fetch('/settime', {
          method: 'POST',
          body: new URLSearchParams({ h, m, s })
        });
        btn.textContent = r.ok ? 'Set!' : 'Error';
      } catch(_) { btn.textContent = 'Error'; }
      setTimeout(() => { btn.textContent = 'Set Time'; btn.disabled = false; }, 2000);
    }

    // ── Manual threshold save ─────────────────────────────────
    async function saveThresholds() {
      const minVal = document.getElementById('thresh-min').value;
      const maxVal = document.getElementById('thresh-max').value;
      const btn = document.getElementById('thresh-save-btn');
      if (!minVal || !maxVal) return;
      btn.disabled = true;
      try {
        const r = await fetch('/setthresholds', {
          method: 'POST',
          body: new URLSearchParams({ min: minVal, max: maxVal })
        });
        btn.textContent = r.ok ? 'Saved!' : 'Error';
      } catch(_) { btn.textContent = 'Error'; }
      setTimeout(() => { btn.textContent = 'Save Thresholds'; btn.disabled = false; }, 2000);
    }

    poll();
    setInterval(poll, 500);
    loadNetworks();
  </script>

</body>
</html>
)rawliteral";

// ── setupWebServer ────────────────────────────────────────────
void setupWebServer() {
    if (serverStarted) return;

    // Load persisted calibration points so buttons show correct state after reboot
    preferences.begin(PREF_NAMESPACE, true);
    calNothing = preferences.getUInt(PREF_KEY_CAL_NOTHING, 0);
    calBottle  = preferences.getUInt(PREF_KEY_CAL_BOTTLE,  0);
    calHand    = preferences.getUInt(PREF_KEY_CAL_HAND,    0);
    preferences.end();

    // ── GET / ─────────────────────────────────────────────────
    server.on("/", HTTP_GET, [](AsyncWebServerRequest *request) {
        request->send(200, "text/html", INDEX_HTML);
    });

    // ── GET /status ───────────────────────────────────────────
    server.on("/status", HTTP_GET, [](AsyncWebServerRequest *request) {
        String t = getCurrentTimeStr();
        String j = "{";
        j += "\"time\":"          "\"" + t             + "\",";
        j += "\"alarmTime\":"     "\"" + alarmTimeStr   + "\",";
        j += "\"buzzerOn\":"          + String(buzzerTestState ? "true" : "false") + ",";
        j += "\"alarmActive\":"       + String(alarmActive     ? "true" : "false") + ",";
        j += "\"capRaw\":"             + String(capRawValue) + ",";
        j += "\"capDetected\":"       + String(capDetected     ? "true" : "false") + ",";
        j += "\"lightDetected\":"     + String(lightDetected   ? "true" : "false") + ",";
        j += "\"storedSSID\":"        "\"" + storedSSID + "\",";
        j += "\"capMin\":"            + String(capBottleMin) + ",";
        j += "\"capMax\":"            + String(capBottleMax) + ",";
        j += "\"ntpTimeoutSec\":"     + String(ntpConnectTimeoutMs / 1000) + ",";
        j += "\"timeSet\":"           + String(isAnyTimeSet() ? "true" : "false");
        j += "}";
        request->send(200, "application/json", j);
    });

    // ── POST /synctime ────────────────────────────────────────
    // Triggers an NTP sync using stored credentials. Returns "OK" or "FAIL".
    server.on("/synctime", HTTP_POST, [](AsyncWebServerRequest *request) {
        bool ok = syncNTP();
        request->send(200, "text/plain", ok ? "OK" : "FAIL");
    });

    // ── GET /scan ─────────────────────────────────────────────
    // Async WiFi scan. First call starts the scan (switches to AP_STA so
    // scanning works) and returns {scanning:true}. Client polls until it
    // gets a JSON array back. scanState resets to 0 after results are read.
    server.on("/scan", HTTP_GET, [](AsyncWebServerRequest *request) {
        if (scanState == 0) {
            WiFi.mode(WIFI_AP_STA);      // Scanning requires STA capability
            WiFi.softAP(AP_SSID);        // Re-assert AP after mode switch
            WiFi.scanNetworks(true);     // true = async, returns immediately
            scanState = 1;
            request->send(200, "application/json", "{\"scanning\":true}");

        } else if (scanState == 1) {
            int n = WiFi.scanComplete(); // -1 = still running, -2 = failed, >=0 = done
            if (n == WIFI_SCAN_RUNNING) {
                request->send(200, "application/json", "{\"scanning\":true}");
            } else if (n == WIFI_SCAN_FAILED || n == 0) {
                WiFi.scanDelete();
                WiFi.mode(WIFI_AP);
                WiFi.softAP(AP_SSID);
                scanState = 0;
                request->send(200, "application/json", "[]");
            } else {
                String j = "[";
                for (int i = 0; i < n; i++) {
                    if (i > 0) j += ",";
                    String ssid = WiFi.SSID(i);
                    ssid.replace("\\", "\\\\");
                    ssid.replace("\"", "\\\"");
                    j += "{\"ssid\":\"" + ssid + "\",\"rssi\":" + String(WiFi.RSSI(i)) + "}";
                }
                j += "]";
                WiFi.scanDelete();
                WiFi.mode(WIFI_AP);
                WiFi.softAP(AP_SSID);
                scanJson  = j;
                scanState = 2;
                request->send(200, "application/json", j);
            }

        } else { // scanState == 2 — cached results
            scanState = 0;
            request->send(200, "application/json", scanJson);
        }
    });

    // ── GET /networks ─────────────────────────────────────────
    // Returns JSON array of all saved networks [{ssid, pass}, ...].
    server.on("/networks", HTTP_GET, [](AsyncWebServerRequest *request) {
        preferences.begin(PREF_NAMESPACE, true);
        int count = preferences.getInt(PREF_KEY_NET_COUNT, 0);
        String j = "[";
        for (int i = 0; i < count; i++) {
            if (i > 0) j += ",";
            String ssid = preferences.getString(("net_ssid_" + String(i)).c_str(), "");
            String pass = preferences.getString(("net_pass_" + String(i)).c_str(), "");
            ssid.replace("\\", "\\\\"); ssid.replace("\"", "\\\"");
            pass.replace("\\", "\\\\"); pass.replace("\"", "\\\"");
            j += "{\"ssid\":\"" + ssid + "\",\"pass\":\"" + pass + "\"}";
        }
        preferences.end();
        j += "]";
        request->send(200, "application/json", j);
    });

    // ── POST /calibrate ───────────────────────────────────────
    // Captures current capRawValue for the given type (nothing/bottle/hand),
    // recomputes thresholds when all three are set, saves to NVS.
    server.on("/calibrate", HTTP_POST, [](AsyncWebServerRequest *request) {
        if (!request->hasParam("type", true)) {
            request->send(400, "text/plain", "Missing type");
            return;
        }
        String t = request->getParam("type", true)->value();
        uint32_t reading = capRawValue;
        if      (t == "nothing") calNothing = reading;
        else if (t == "bottle")  calBottle  = reading;
        else if (t == "hand")    calHand    = reading;
        else { request->send(400, "text/plain", "Bad type"); return; }

        if (calNothing > 0 && calBottle > 0 && calHand > 0) {
            capBottleMin = (calNothing + calBottle) / 2;
            capBottleMax = (calBottle  + calHand)   / 2;
            preferences.begin(PREF_NAMESPACE, false);
            preferences.putUInt(PREF_KEY_CAL_NOTHING, calNothing);
            preferences.putUInt(PREF_KEY_CAL_BOTTLE,  calBottle);
            preferences.putUInt(PREF_KEY_CAL_HAND,    calHand);
            preferences.putUInt(PREF_KEY_CAP_MIN,     capBottleMin);
            preferences.putUInt(PREF_KEY_CAP_MAX,     capBottleMax);
            preferences.end();
            Serial.printf("[CAL] nothing=%lu  bottle=%lu  hand=%lu  min=%lu  max=%lu\n",
                          calNothing, calBottle, calHand, capBottleMin, capBottleMax);
        }

        String j = "{";
        j += "\"nothing\":" + String(calNothing) + ",";
        j += "\"bottle\":"  + String(calBottle)  + ",";
        j += "\"hand\":"    + String(calHand)    + ",";
        j += "\"min\":"     + String(capBottleMin) + ",";
        j += "\"max\":"     + String(capBottleMax);
        j += "}";
        request->send(200, "application/json", j);
    });

    // ── POST /settime ─────────────────────────────────────────
    // Manually sets the clock to HH:MM:SS without NTP.
    // Epoch is computed as one day + local seconds - UTC offset so getHours()/getMinutes() return correctly.
    server.on("/settime", HTTP_POST, [](AsyncWebServerRequest *request) {
        int h = request->hasParam("h", true) ? request->getParam("h", true)->value().toInt() : 0;
        int m = request->hasParam("m", true) ? request->getParam("m", true)->value().toInt() : 0;
        int s = request->hasParam("s", true) ? request->getParam("s", true)->value().toInt() : 0;
        h = constrain(h, 0, 23);
        m = constrain(m, 0, 59);
        s = constrain(s, 0, 59);
        manualHour    = h;
        manualMinute  = m;
        manualSecond  = s;
        manualSetAt   = millis();
        manualTimeSet = true;
        Serial.printf("[TIME] Manual time set to %02d:%02d:%02d\n", h, m, s);
        request->send(200, "text/plain", "OK");
    });

    // ── POST /settimeout ──────────────────────────────────────
    // Sets WiFi connection timeout in seconds, persists to NVS.
    server.on("/settimeout", HTTP_POST, [](AsyncWebServerRequest *request) {
        if (!request->hasParam("seconds", true)) {
            request->send(400, "text/plain", "Missing seconds");
            return;
        }
        uint32_t secs = (uint32_t)request->getParam("seconds", true)->value().toInt();
        if (secs < 5) secs = 5;
        ntpConnectTimeoutMs = secs * 1000;
        preferences.begin(PREF_NAMESPACE, false);
        preferences.putUInt(PREF_KEY_NTP_TIMEOUT, ntpConnectTimeoutMs);
        preferences.end();
        Serial.printf("[CFG] WiFi timeout set to %lu s\n", secs);
        request->send(200, "text/plain", "OK");
    });

    // ── POST /setthresholds ───────────────────────────────────
    // Manually overrides cap sensor min/max thresholds and persists to NVS.
    server.on("/setthresholds", HTTP_POST, [](AsyncWebServerRequest *request) {
        if (request->hasParam("min", true))
            capBottleMin = (uint32_t)request->getParam("min", true)->value().toInt();
        if (request->hasParam("max", true))
            capBottleMax = (uint32_t)request->getParam("max", true)->value().toInt();
        preferences.begin(PREF_NAMESPACE, false);
        preferences.putUInt(PREF_KEY_CAP_MIN, capBottleMin);
        preferences.putUInt(PREF_KEY_CAP_MAX, capBottleMax);
        preferences.end();
        Serial.printf("[CFG] Thresholds updated: min=%lu  max=%lu\n", capBottleMin, capBottleMax);
        request->send(200, "text/plain", "OK");
    });

    // ── POST /setalarm ────────────────────────────────────────
    // Updates the alarm time in NVS and globals without rebooting.
    server.on("/setalarm", HTTP_POST, [](AsyncWebServerRequest *request) {
        if (!request->hasParam("alarm", true)) {
            request->send(400, "text/plain", "Missing alarm param");
            return;
        }
        String newAlarm = request->getParam("alarm", true)->value();
        alarmTimeStr = newAlarm;
        parseAlarmTime(newAlarm);           // Updates alarmHour / alarmMinute globals
        preferences.begin(PREF_NAMESPACE, false);
        preferences.putString(PREF_KEY_ALARM, newAlarm);
        preferences.end();
        Serial.printf("[ALARM] Updated to '%s'\n", newAlarm.c_str());
        request->send(200, "text/plain", "OK");
    });

    // ── POST /buzzer ──────────────────────────────────────────
    server.on("/buzzer", HTTP_POST, [](AsyncWebServerRequest *request) {
        bool on = request->hasParam("on", true) &&
                  request->getParam("on", true)->value() == "1";
        buzzerTestState = on;
        digitalWrite(BUZZER_PIN, on ? HIGH : LOW);
        Serial.printf("[DEV] Buzzer manually set %s\n", on ? "ON" : "OFF");
        request->send(200, "text/plain", "OK");
    });

    // ── POST /save ────────────────────────────────────────────
    // Saves WiFi credentials (and optionally alarm time) then reboots.
    server.on("/save", HTTP_POST, [](AsyncWebServerRequest *request) {
        String newSSID  = request->hasParam("ssid",  true)
                          ? request->getParam("ssid",  true)->value() : storedSSID;
        String newPass  = request->hasParam("pass",  true)
                          ? request->getParam("pass",  true)->value() : storedPassword;
        String newAlarm = request->hasParam("alarm", true)
                          ? request->getParam("alarm", true)->value() : alarmTimeStr;

        preferences.begin(PREF_NAMESPACE, false);
        preferences.putString(PREF_KEY_SSID,  newSSID);
        preferences.putString(PREF_KEY_PASS,  newPass);
        preferences.putString(PREF_KEY_ALARM, newAlarm);

        // Upsert into saved network list (max MAX_SAVED_NETWORKS, drop oldest on overflow)
        int count = preferences.getInt(PREF_KEY_NET_COUNT, 0);
        bool found = false;
        for (int i = 0; i < count; i++) {
            if (preferences.getString(("net_ssid_" + String(i)).c_str(), "") == newSSID) {
                preferences.putString(("net_pass_" + String(i)).c_str(), newPass);
                found = true;
                break;
            }
        }
        if (!found) {
            if (count >= MAX_SAVED_NETWORKS) {
                // Shift list left to drop the oldest entry
                for (int i = 0; i < count - 1; i++) {
                    preferences.putString(("net_ssid_" + String(i)).c_str(),
                        preferences.getString(("net_ssid_" + String(i + 1)).c_str(), ""));
                    preferences.putString(("net_pass_" + String(i)).c_str(),
                        preferences.getString(("net_pass_" + String(i + 1)).c_str(), ""));
                }
                count = MAX_SAVED_NETWORKS - 1;
            }
            preferences.putString(("net_ssid_" + String(count)).c_str(), newSSID);
            preferences.putString(("net_pass_" + String(count)).c_str(), newPass);
            preferences.putInt(PREF_KEY_NET_COUNT, count + 1);
        }

        preferences.end();

        Serial.printf("[SAVE] SSID='%s'  Alarm='%s' — rebooting\n",
                      newSSID.c_str(), newAlarm.c_str());
        request->send(200, "text/plain", "OK");
        delay(300);
        ESP.restart();
    });

    server.begin();
    serverStarted = true;
    Serial.println("[SERVER] Web server running at " AP_GATEWAY_IP);
}
