AdyanshSahai/AquaLux/(commit log)

2026-06-06 changed pin values to real
2026-06-06 added photoresistor properly, changed pin numbers again so it is safe
2026-06-06 switched photo-pin and ir so that it is easier to breadboard
2026-06-06 fix compilation error of photoresistor pin vs actual photoresistor...
    [main.cpp]
2026-06-06 fix boot crash: defer timeClient.begin() until after WiFi stack init, fix NVS first-boot error
    [main.cpp, wifi_ntp.cpp]
2026-06-06 make sensors read constantly for testing purposes.
2026-06-06 fix the connection error....
    [config.h]
2026-06-06 fixing photoresistor and spring switch measurement
    [config.h, globals.cpp, globals.h, main.cpp, sensors.cpp, webserver.cpp]
2026-06-09 major changes, added cap sensor, web ui upgrade, photoresistor, removed ir
2026-06-09 fixing buzzer code in devmode, also, adding capacitive readings...
    [alarm.cpp, config.h, globals.cpp, globals.h, main.cpp, reset_button.cpp, sensors.cpp, webserver.cpp]
2026-06-09 make sure the esp does NOT reset via brownout
    [alarm.cpp, main.cpp, reset_button.cpp, webserver.cpp, wifi_ntp.cpp]
2026-06-10 major fixes to onboarding... added wifi selection and manual ntp sync
    [webserver.cpp]
2026-06-10 fix wifi scan functionality
    [webserver.cpp]
2026-06-20 added flowchart and schematics
    [AquaLux.kicad_pcb, AquaLux.kicad_sch]
2026-06-24 fixed a variety of issues, including wifi credential storage, logging, threshold setting, light detection, etc.
    [AquaLux.kicad_sch]
2026-06-24 bugfix on time setting
    [globals.cpp, globals.h, main.cpp, webserver.cpp, wifi_ntp.cpp, wifi_ntp.h]
2026-06-25 added kicad schematics properly.
    [AquaLux.kicad_sch]
2026-10-16 Remove KiCad auto-save and lock files from version control
2026-10-16 Describe the J5109 power module and reword the pad location in README
